piperendervt-glitch/fiberfeel-rig/(commit log)

2026-04-29 Add shakedown mode and switch RAW format to .npy
    * measurement/capture.py: new --mode shakedown for engineering
    verification (outside preregistration scope). Skips run_config.yaml
    TBD checks; exposure / frame count come from CLI; saving is opt-in.
    Prints per-frame max / mean / center-200x200 ROI stats and warns on
    saturation (>95% of 12-bit full) and low brightness (<5%).
    * measurement/capture.py: phase1 / baseline modes now save RAW frames
    as numpy .npy via np.save(request.make_array('raw')) instead of DNG,
    removing the rawpy / libraw dependency from the analysis pipeline.
    Filename convention: <condition_id>_<frame_idx:03d>.npy.
    Per-frame metadata (capture time, exposure, g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
    [capture.py]
2026-04-29 Fix gel_mold.scad: cavity was sealed under top wall
    Root cause was different from the initial hypothesis (hull operation
    order). The bug was that mold_outer_z = mold_floor_mm + pad_thickness_mm
    + 1 = 7, while tapered_cavity() only extruded pad_thickness_mm = 3 above
    the floor. The remaining 1mm at the top was never subtracted, so the
    mold rendered as a solid box with an internal sealed pocket. Visible
    as a flat top in Top View.
    Fix: split tapered_cavity() into a tapered PDMS-fill section
    (pad_thickness_mm tall, 1° draft) plus a straight rim section that
    overshoots mold_outer_z by top_fillet_r + 2*eps so the cavity is
    guaranteed to break through the top regardless of fillet rounding.
    Also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
    [gel_mold.scad]
2026-04-29 Fix camera_fiber_coupler: open front face for light path, verify fiber_holder Z alignment
    Two bugs fixed:
    1. Front wall blocked the light path. Original cradle was an outer cube
    (40 x 60 x 42) minus a 19-deep cavity, leaving ~21mm of solid material
    between the camera lens (x=21) and the fiber holder direction (+X).
    Restructured as additive U-shape: back wall (2mm in X) + left wall
    (2mm in Y) + right wall (2mm in Y), with no front wall and no top.
    Cradle Y reduced from 60 to 42.5 (centered on plate) so the side
    walls match the spec'd 2mm thickness rather than the inadvertent
    10.75mm. Camera now sits in an open U with the lens looking straight
    out to the rail at +X.
    2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
    [camera_fiber_coupler.scad]
2026-04-29 Add remaining Phase 0/1 hardware designs and gitignore STL artifacts
    [bend_jig_r10.scad, led_fiber_coupler.scad, params.scad, weight_guide.scad]
2026-04-30 Add HQ Camera mount holes and widen LED-side POF channel
    [camera_fiber_coupler.scad, led_fiber_coupler.scad, params.scad]
2026-04-30 Update HQ Camera mount holes to 30mm pitch (M2.5) and widen LED POF channel to 1.8mm
    [camera_fiber_coupler.scad, params.scad]
2026-04-30 Add 180x180x100 light-tight enclosure with cable baffles
    [enclosure.scad, params.scad]
2026-05-03 Fix enclosure_lid: remove handle recess (was through-hole due to spec mismatch)
    [enclosure.scad]
2026-05-03 Fix RAW capture: unpack 12bit packed (SBGGR12_CSI2P) to uint16
    [capture.py]
2026-05-03 Fix picamera2 exposure control: explicit start() + set_controls() with warmup
    [capture.py]
2026-05-03 Fix RAW dispatch: handle uint16 LE bytes returned as uint8 array
    [capture.py]
2026-05-03 Add led_back_cap to seal LED-side opening of led_fiber_coupler
    [led_back_cap.scad, params.scad]
2026-05-03 Fix led_back_cap press-fit depth: 2mm -> 6mm to engage Ø5.1 LED hole
    [params.scad]
2026-05-03 Restructure LED housing: deep LED hole (8mm) + back cap boss in Ø7 zone
    Resolved physical interference between LED bullet and led_back_cap boss
    in the Ø5.1 zone (former z=5..8). Restacked the coupler so the LED body
    hole and the back-cap press-fit no longer overlap:
    z = 0 .. 5 Ø7 リード逃げ / led_back_cap boss 圧入域
    z = 5 .. 13 Ø5.1 LED 砲弾 8mm 全長収納
    z = 13 .. 14 実体 LED 上面と POF 端面を隔てる 1mm 壁
    z = 14 .. 24 Ø1.8 POF 縦穴
    Coupler total height 18 → 24mm. led_back_cap boss Ø5.1×6 → Ø6.9×5
    (0.1mm interference fit in the Ø7 zone). led_back_cap.scad is unchanged
    because it consumes the press-fit dimensions from param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
    [led_fiber_coupler.scad, params.scad]
2026-05-03 Extend LED body hole: 8mm -> 10mm (coupler total height 24->26)
    LED 砲弾 (8mm) と Ø5.1 穴 (10mm) の z 余裕を 0mm → 2mm に拡大し、
    組み立て時の許容差を確保する。led_back_cap (boss は Ø7 ザグリに圧入)
    は影響を受けず、再印刷不要。
    新しい z スタック:
    z = 5 .. 15 Ø5.1 LED 本体穴 (8mm → 10mm)
    z = 15 .. 16 実体 1mm 壁
    z = 16 .. 26 Ø1.8 POF 縦穴
    led_fiber_coupler.scad は params.scad の led_body_depth_mm から
    全寸を導出するため、コードの構造変更はなし（コメントの z 値のみ更新）。
    OpenSCAD で再レンダ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
    [led_fiber_coupler.scad, params.scad]
2026-05-03 Record deviation: σ_baseline measured with bend_jig installed (§5.1)
2026-05-03 Set ExposureTime_us=1500 (§4-compliant: frame max 63%); record ROI brightness interpretation
2026-05-03 Fix TBD validation: per-mode required fields (baseline doesn't need random_seed)
    [capture.py]
2026-05-03 Record §4 LED stability deviation: session01/02 fail, LM317 retrofit planned
2026-05-03 Redesign hardware for Phase 1: baseplate + U-shape layout, common POF axis z=23
    [baseplate.scad, bend_jig_r10.scad, camera_fiber_coupler.scad, led_fiber_coupler.scad, params.scad, weight_guide.scad]
